Hooligan-0/ek-fpga_miniterm/hw-miniterm_pcb-rev_a/photo/front_view.jpg

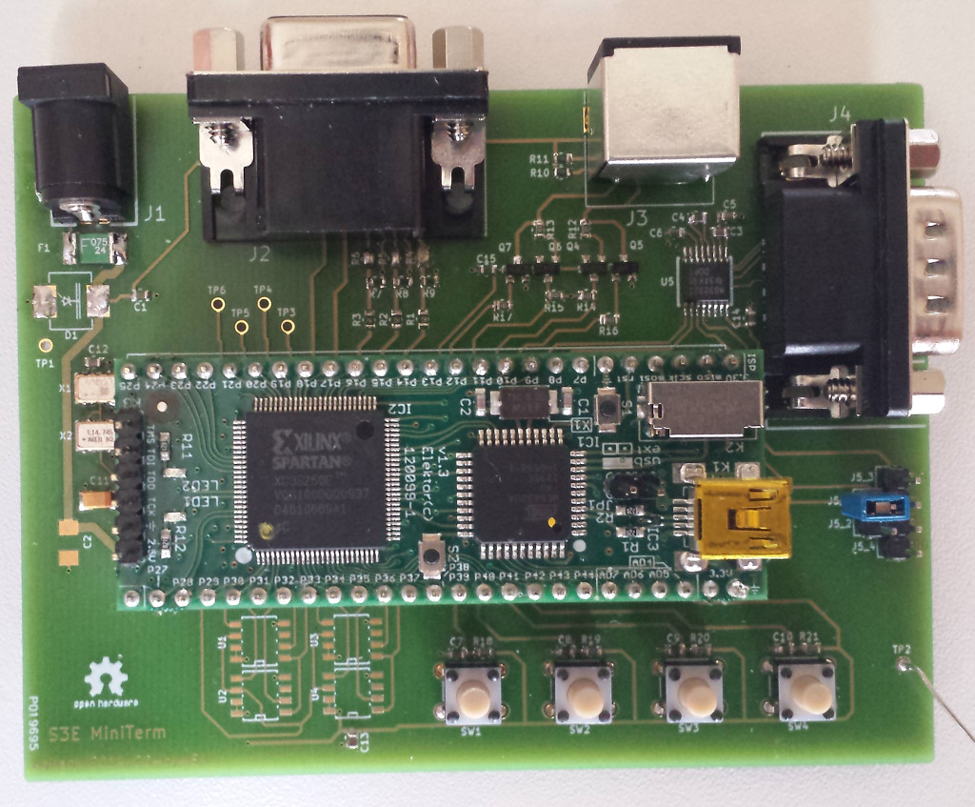
hw-miniterm_pcb-rev_a/photo/front_view.jpg
