Hooligan-0/ek-fpga_miniterm/README.md

ek-fpga_miniterm
================

VGA terminal emulator based on EK-120099 FPGA module
