Hooligan-0/ek-fpga_miniterm/hw-miniterm_pcb-rev_a/prj-kicad/ek-s3e_miniterm.kicad_pcb

## KiCad design hw-miniterm_pcb-rev_a/prj-kicad/ek-s3e_miniterm.kicad_pcb (2015-05-25)

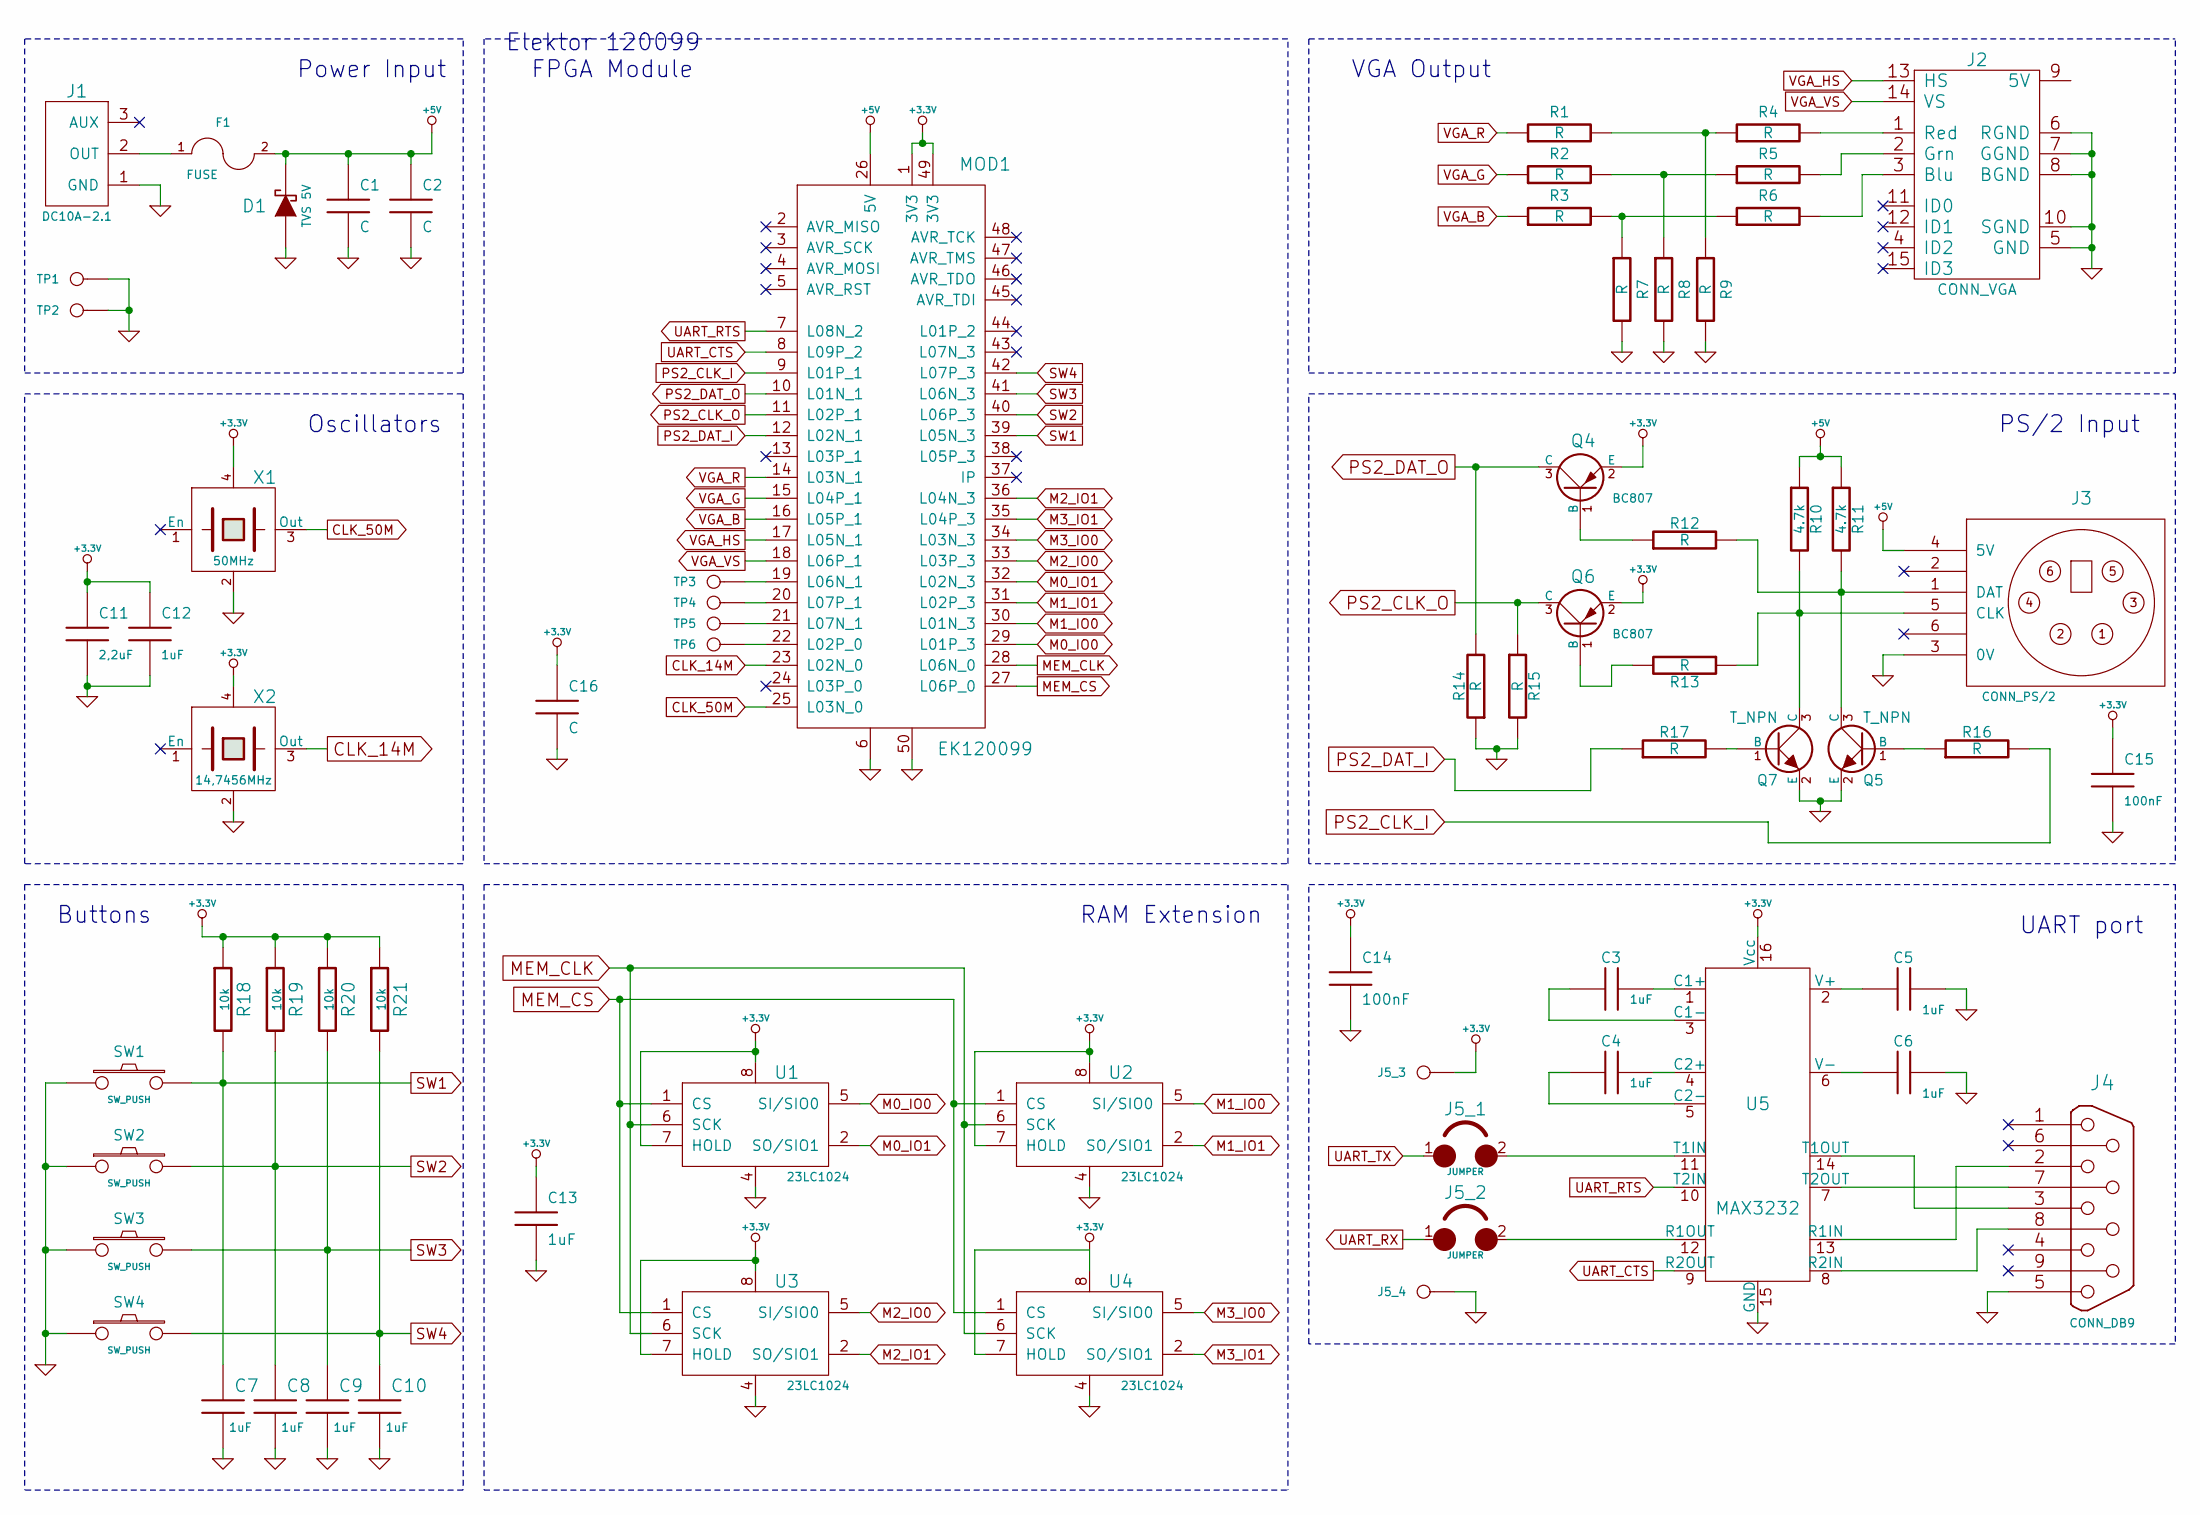
[picture p2: schematic ek-s3e_miniterm.sch, MiniTerm for Elektor 120099 FPGA module]

Parts:
C1, C2, C16: C
C3, C4, C5, C6, C7, C8, C9, C10, C12, C13: 1uF
C11: 2,2uF
C14, C15: 100nF
D1: TVS 5V
F1: FUSE
J1: DC10A-2.1
J2: CONN_VGA
J3: CONN_PS/2
J4: CONN_DB9
J5_1, J5_2: JUMPER
J5_3, J5_4: CONN_1
MOD1: EK120099
Q4, Q6: BC807
Q5, Q7: T_NPN
R1, R2, R3, R4, R5, R6, R7, R8, R9, R12, R13, R14, R15, R16, R17: R
R10, R11: 4.7k
R18, R19, R20, R21: 10k
SW1, SW2, SW3, SW4: SW_PUSH
TP1, TP2, TP3, TP4, TP5, TP6: CONN_1
U1, U2, U3, U4: 23LC1024
U5: MAX3232
X1: 50MHz
X2: 14,7456MHz

Connections:
+3.3V: C11.1, C12.1, C13.1, C14.1, C15.1, C16.1, J5_3.1, MOD1.1 (3V3), MOD1.49 (3V3), Q4.2 (E), Q6.2 (E), R18.1, R19.1, R20.1, R21.1, U1.7 (HOLD), U1.8, U2.7 (HOLD), U2.8, U3.7 (HOLD), U3.8, U4.7 (HOLD), U4.8, U5.16 (Vcc), X1.4, X2.4
+5V: C1.1, C2.1, D1.2 (K), F1.2, J3.4 (5V), MOD1.26 (5V), R10.1, R11.1
CLK_14M: MOD1.23 (L02N_0), X2.3 (Out)
CLK_50M: MOD1.25 (L03N_0), X1.3 (Out)
GND: C1.2, C2.2, C5.2, C6.2, C7.2, C8.2, C9.2, C10.2, C11.2, C12.2, C13.2, C14.2, C15.2, C16.2, D1.1 (A), J1.1 (GND), J2.5 (GND), J2.6 (RGND), J2.7 (GGND), J2.8 (BGND), J2.10 (SGND), J3.3 (0V), J4.5, J5_4.1, MOD1.6, MOD1.50, Q5.2 (E), Q7.2 (E), R7.2, R8.2, R9.2, R14.1, R15.2, SW1.1, SW2.1, SW3.1, SW4.1, TP1.1, TP2.1, U1.4, U2.4, U3.4, U4.4, U5.15 (GND), X1.2, X2.2
M0_IO0: MOD1.29 (L01P_3), U1.5 (SI/SIO0)
M0_IO1: MOD1.32 (L02N_3), U1.2 (SO/SIO1)
M1_IO0: MOD1.30 (L01N_3), U2.5 (SI/SIO0)
M1_IO1: MOD1.31 (L02P_3), U2.2 (SO/SIO1)
M2_IO0: MOD1.33 (L03P_3), U3.5 (SI/SIO0)
M2_IO1: MOD1.36 (L04N_3), U3.2 (SO/SIO1)
M3_IO0: MOD1.34 (L03N_3), U4.5 (SI/SIO0)
M3_IO1: MOD1.35 (L04P_3), U4.2 (SO/SIO1)
MEM_CLK: MOD1.28 (L06N_0), U1.6 (SCK), U2.6 (SCK), U3.6 (SCK), U4.6 (SCK)
MEM_CS: MOD1.27 (L06P_0), U1.1 (CS), U2.1 (CS), U3.1 (CS), U4.1 (CS)
unnamed: C6.1, U5.6 (V-)
unnamed: C4.2, U5.4 (C2+)
unnamed: C3.1, U5.3 (C1-)
unnamed: C3.2, U5.1 (C1+)
unnamed: C4.1, U5.5 (C2-)
unnamed: C5.1, U5.2 (V+)
unnamed: J4.8, U5.8 (R2IN)
unnamed: J4.2, U5.13 (R1IN)
unnamed: J5_1.2, U5.11 (T1IN)
unnamed: J5_2.2, U5.12 (R1OUT)
unnamed: J4.7, U5.7 (T2OUT)
unnamed: J4.3, U5.14 (T1OUT)
unnamed: MOD1.21 (L07N_1), TP5.1
unnamed: MOD1.19 (L06N_1), TP3.1
unnamed: MOD1.20 (L07P_1), TP4.1
unnamed: MOD1.22 (L02P_0), TP6.1
unnamed: F1.1, J1.2 (OUT)
unnamed: Q7.1 (B), R17.2
unnamed: Q5.1 (B), R16.1
unnamed: Q6.1 (B), R13.2
unnamed: Q4.1 (B), R12.1
unnamed: J2.2 (Grn), R5.2
unnamed: J2.3 (Blu), R6.2
unnamed: J2.1 (Red), R4.2
unnamed: J3.1 (DAT), Q5.3 (C), R11.2, R12.2
unnamed: J3.5 (CLK), Q7.3 (C), R10.2, R13.1
unnamed: R1.2, R4.1, R9.1
unnamed: R2.2, R5.1, R8.1
unnamed: R3.2, R6.1, R7.1
PS2_CLK_I: MOD1.9 (L01P_1), R16.2
PS2_CLK_O: MOD1.11 (L02P_1), Q6.3 (C), R15.1
PS2_DAT_I: MOD1.12 (L02N_1), R17.1
PS2_DAT_O: MOD1.10 (L01N_1), Q4.3 (C), R14.2
SW1: C7.1, MOD1.39 (L05N_3), R18.2, SW1.2
SW2: C8.1, MOD1.40 (L06P_3), R19.2, SW2.2
SW3: C9.1, MOD1.41 (L06N_3), R20.2, SW3.2
SW4: C10.1, MOD1.42 (L07P_3), R21.2, SW4.2
UART_CTS: MOD1.8 (L09P_2), U5.9 (R2OUT)
UART_RTS: MOD1.7 (L08N_2), U5.10 (T2IN)
VGA_B: MOD1.16 (L05P_1), R3.1
VGA_G: MOD1.15 (L04P_1), R2.1
VGA_HS: J2.13 (HS), MOD1.17 (L05N_1)
VGA_R: MOD1.14 (L03N_1), R1.1
VGA_VS: J2.14 (VS), MOD1.18 (L06P_1)

Notes on the sheet:
PS/2 Input
VGA Output
RAM Extension
UART port
Buttons
Oscillators
Power Input
Elektor 120099 FPGA Module

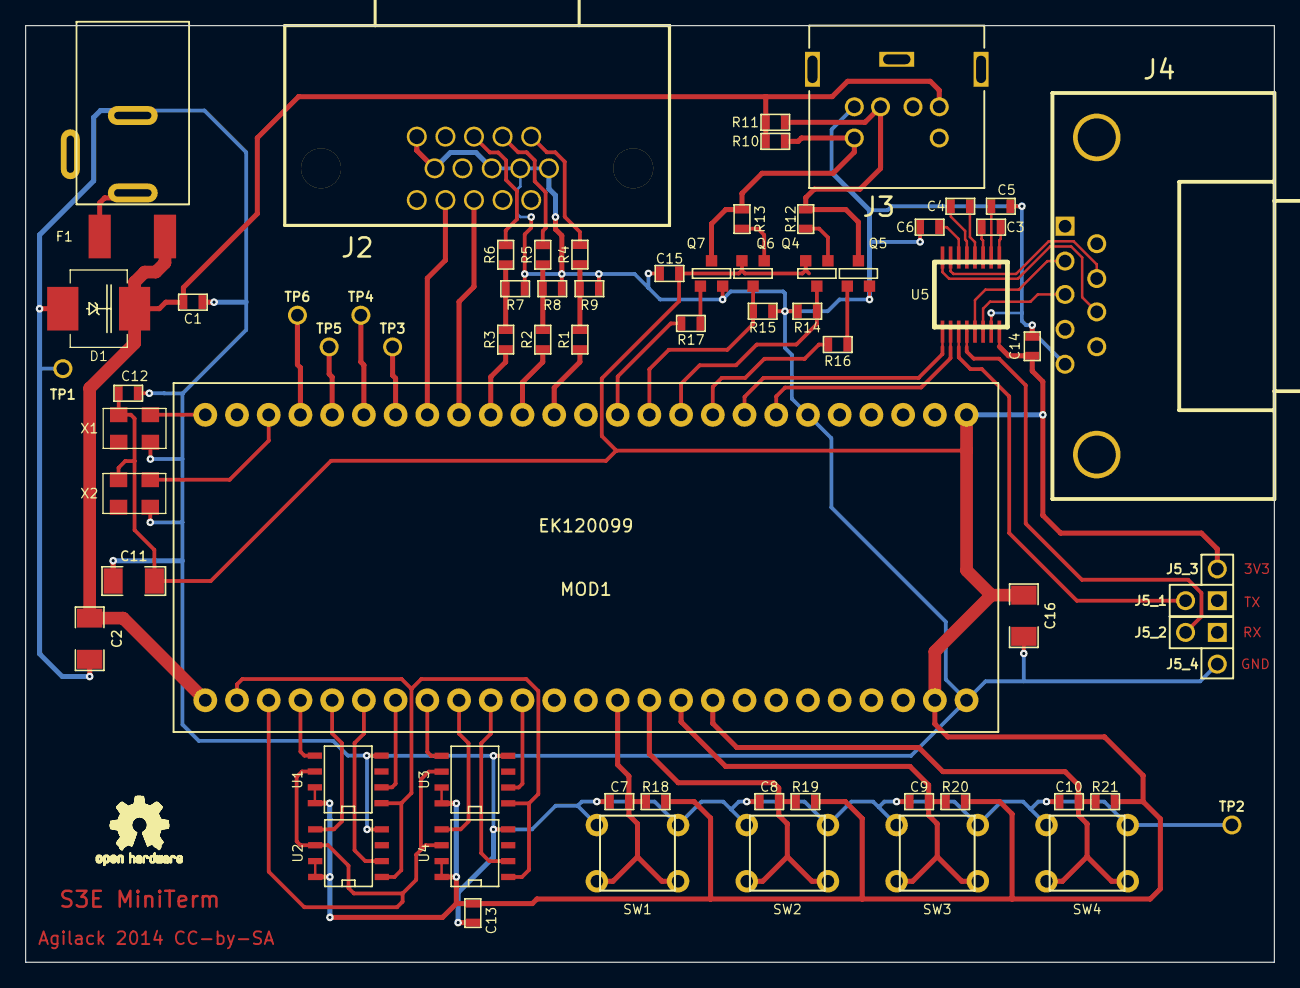
[picture p3: board ek-s3e_miniterm.kicad_pcb from above]

Board: 2 copper layers, 100.0 x 75.0 mm, 70 parts (0 on the bottom side), 59 nets.

Other parts of the board:
ohw_logo: VAL**; ohw_logo
