Hooligan-0/ek-fpga_miniterm/hdl-ut_sram/rtl/fsm_ut/fsm_ut_sram.v

/**
 *  EK-Miniterm - Finite State Machine for SRAM unit-test
 *
 * Copyright (C) 2014 Saint-Genest Gwenael <gwen@agilack.fr>
 *
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
 * You should have received a copy of the GNU Library General Public
 * License along with this program; if not, write to the Free Software
 * Foundation, Inc., 51 Franklin Street, Fifth Floor, Boston, MA 02110-1301,
 * USA.
 */
`timescale 1ns / 1ps
module fsm_ut_sram(
	input         rst_i,
	input         wb_clk_i,
	output        wb_cyc_o,
	output        wb_we_o,
	input         wb_ack_i,
	output [16:0] wb_addr_o,
	input  [ 7:0] wb_datr_i,
	output [ 7:0] wb_datw_o
);

reg [ 3:0] state;
reg [16:0] wb_addr;
reg [ 7:0] wb_datw;
reg wb_cyc;
reg wb_we;
assign wb_cyc_o  = wb_cyc;
assign wb_we_o   = wb_we;
assign wb_addr_o = wb_addr;
assign wb_datw_o = wb_datw;

always @(posedge wb_clk_i)
begin
	if (rst_i == 1'b1) begin
		state   <= 4'd0;
		wb_cyc  <= 1'b0;
		wb_we   <= 1'b0;
		wb_addr <= 17'b0;
	end else begin
		case(state)
			4'b0000: begin
				wb_addr <= 17'b00;
				state   <= 4'h4;
			end
			4'h1: begin
				wb_addr <= 17'b00;
				state   <= 4'h8;
			end
			4'h2: begin
				//
			end
			
			// Write
			4'h4: begin
				if (wb_ack_i == 1'b0) begin
					wb_datw <= ~(wb_addr[7:0]);
					wb_cyc  <= 1'b1;
					wb_we   <= 1'b1;
				end else begin
					wb_cyc <= 1'b0;
					state  <= 4'h5;
				end
			end
			4'h5: begin
				wb_addr <= wb_addr + 17'd1;
				if (wb_addr < 17'h004FF)
					state  <= 4'h4;
				else
					state  <= 4'h1;
			end

			// Read
			4'h8: begin
				if (wb_ack_i == 1'b0) begin
					wb_cyc  <= 1'b1;
					wb_we   <= 1'b0;
				end else begin
					wb_cyc <= 1'b0;
					state  <= 4'h9;
				end
			end
			4'h9: begin
				wb_addr <= wb_addr + 17'd1;
				if (wb_addr < 17'h004FF)
					state  <= 4'h8;
				else
					state  <= 4'h2;
			end
			
			default: begin
				state <= 4'h0;
			end
		endcase
	end
end

endmodule
