Hooligan-0/ek-fpga_miniterm/(commit log)

2014-05-06 = Unit-test for UART interface - This test create an echo function - Simulate RX and TX at 115200 baud - Tested on board r02 (bytes are well received)
2014-05-08 = Unit-test for external SRAM chip - Test write-to and read-from SRAM using SPI protocol - Currently limited to 1 bit spi mode (SDI and SQI not implemented) - Verified only into simulator (ISIM)
2015-05-25 = ADD: Kicad project for the first prototype
    [ek-s3e_miniterm.kicad_pcb, ek-s3e_miniterm.sch]
2015-05-26 = ADD: Production files for the first PCB prototype
    [ek-s3e_miniterm-B_Cu.gbl, ek-s3e_miniterm-B_Mask.gbs, ek-s3e_miniterm-B_Paste.gbp, ek-s3e_miniterm-Edge_Cuts.gbr, ek-s3e_miniterm-F_Cu.gtl, ek-s3e_miniterm-F_Mask.gts, ek-s3e_miniterm-F_Paste.gtp, ek-s3e_miniterm-F_SilkS.gto]
2015-06-19 = ADD: first picture of the board (without SRAM)
