Hooligan-0/ek-fpga_miniterm/(notices)

Notices in the files:
hdl-ut_serial/rtl/uart/uart.v:
under the terms of the GNU General Public License as published
hw-miniterm_pcb-rev_a/prj-kicad/ek-s3e_miniterm.kicad_pcb:
Agilack 2014 CC-by-SA
